Keyzoo0/PemilahBuahNaga/README.md

# 🐉 PemilahBuahNaga

**Sistem konveyor pemilah buah naga otomatis** berbasis **Raspberry Pi 5 + YOLOv8 + Arduino Nano**.
Kamera mendeteksi & mengklasifikasi tingkat kematangan buah naga secara real-time, lalu konveyor
dan lengan servo menyortirnya ke jalur yang sesuai — **berjalan mandiri (offline-first)** tanpa
laptop dan tanpa perlu membuka web.

<p align="center">
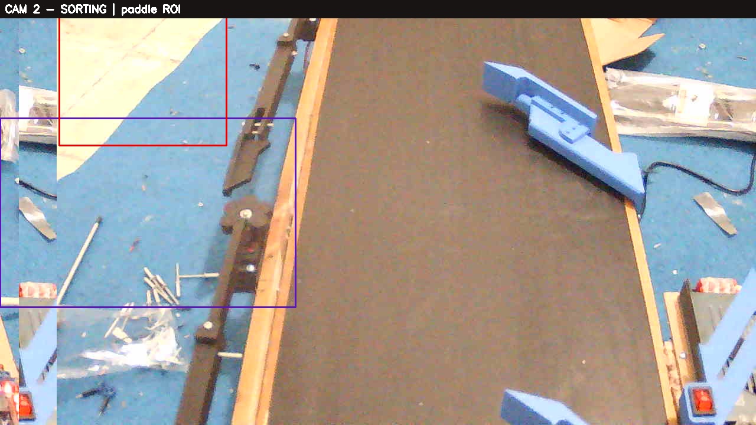
[picture p1: docs/images/sorting_zone.jpg]
Zona sorting: konveyor + 2 lengan servo + ROI paddle
  
</p>

> Deteksi & keputusan sortasi 100% dijalankan di Raspberry Pi 5. Web (Vite + React) hanya untuk
> **monitoring & kalibrasi** — sistem tetap menyortir walau web ditutup atau internet mati.

---

## ✨ Fitur

- 🍎 **Klasifikasi 3 kelas** kematangan: `matang`, `setengah matang`, `mentah` (YOLOv8).
- 🎥 **Dual kamera USB** — Kamera 1 deteksi + klasifikasi, Kamera 2 tracking gerakan saat sorting.
- 🔀 **Sortasi otomatis** via 2 lengan servo + konveyor (motor L298N) dengan mekanisme "tampol".
- 🧠 **State machine** lengkap dengan **failsafe**: watchdog motor, auto-reconnect serial, E-STOP.
- 🌐 **Web monitoring & kalibrasi** (offline/LAN): stream langsung, editor ROI visual, hot-reload config.
- 🔎 **mDNS** — akses langsung di **`http://buahnaga.local:5000`** tanpa perlu tahu alamat IP.
- 🔌 **Identifikasi kamera by USB bus-key** — cam1/cam2 tidak pernah tertukar walau reboot.
- ⚙️ **Systemd service** — otomatis menyala saat boot.

---

## 🧩 Arsitektur

```mermaid
flowchart LR
    subgraph PI[Raspberry Pi 5 - systemd service]
        CAM[CameraManager<br/>2 USB cam by bus-key] --> YOLO[YOLOv8 best.pt]
        YOLO --> SM[Sort State Machine]
        SM --> SER[Serial Bridge]
        SM --> API[FastAPI + WebSocket]
        API --> WEB[Web Vite+React<br/>monitor & kalibrasi]
        CFG[config.json hot-reload] --> SM
    end
    SER -->|USB 115200| NANO[Arduino Nano]
    NANO --> MOT[Motor L298N]
    NANO --> S1[Servo 1]
    NANO --> S2[Servo 2]
    NANO --> LED[LED hijau/kuning/merah]
    NANO --> BUZ[Buzzer]
```

Semua inti (YOLO + state machine + serial) berada di **satu service Python** yang selalu berjalan.
Web adalah build statik yang di-serve service yang sama.

---

## 🔩 Hardware

| Komponen | Detail |
|---|---|
| **Compute** | Raspberry Pi 5 (BCM2712, 4×Cortex-A76 @2.4GHz, 8GB) — Debian 13 |
| **Mikrokontroler** | Arduino Nano (ATmega328P) via USB serial `/dev/ttyUSB0` @115200 |
| **Kamera** | 2× USB camera (DV20/Jieli) — cam1 deteksi, cam2 sorting |
| **Aktuator** | Motor DC konveyor (driver L298N), 2× Servo, 3× LED, Buzzer |

### Pinout Arduino Nano
| Pin | Fungsi | | Pin | Fungsi |
|---|---|---|---|---|
| D2 / D3 | Motor L298N IN1 / IN2 | | D11 | LED hijau (matang) |
| D4 / D5 | Servo 1 / Servo 2 | | D12 | LED kuning (setengah matang) |
| D6 | Buzzer | | D13 | LED merah (mentah) |

---

## 🍎 Model YOLOv8

Model `best.pt` (3 kelas). Contoh deteksi pada belt:

<p align="center">
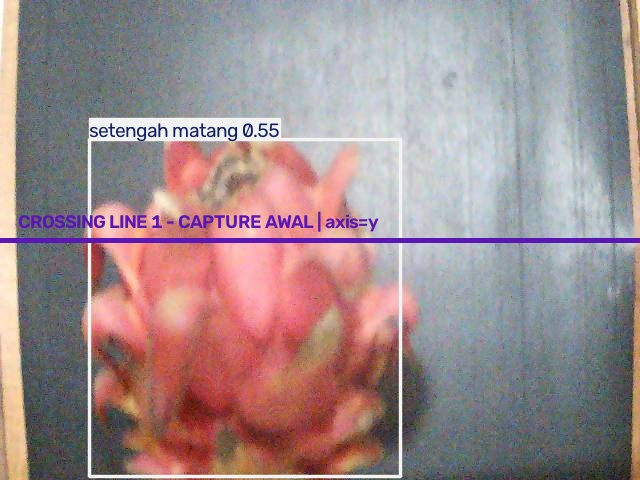
[picture p2: docs/images/detection_top.jpg]
Deteksi kamera atas
  
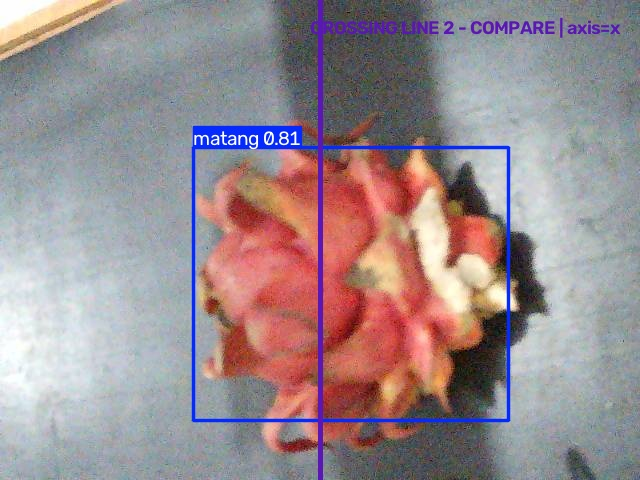
[picture p3: docs/images/detection_side.jpg]
Deteksi kamera samping
  
</p>

| Index | Kelas | Aksi sortasi |
|---|---|---|
| 0 | `matang` | 🟢 Lurus keluar (tanpa servo) |
| 1 | `mentah` | 🔴 Servo 1 (paling dekat) |
| 2 | `setengah matang` | 🟡 Servo 2 |

**Performa di Pi 5** (CPU, 4 thread): imgsz 480 ≈ **5 FPS**, imgsz 320 ≈ **10 FPS**.
Bisa ~2× lebih cepat dengan export NCNN.

### 📊 Hasil Training

Evaluasi model aktif (training 23 Sep 2026, imgsz 416) pada **125 foto uji**:

| Kelas | Jumlah | Precision | Recall | mAP50 | mAP50-95 |
|---|---|---|---|---|---|
| **Semua** | 125 | 97.2% | 96.9% | 98.6% | 75.6% |
| `matang` | 30 | 91.5% | 100% | 97.0% | 73.7% |
| `mentah` | 44 | 100% | 99.6% | 99.5% | 77.4% |
| `setengah matang` | 51 | 100% | 91.1% | 99.3% | 75.6% |

<p align="center">
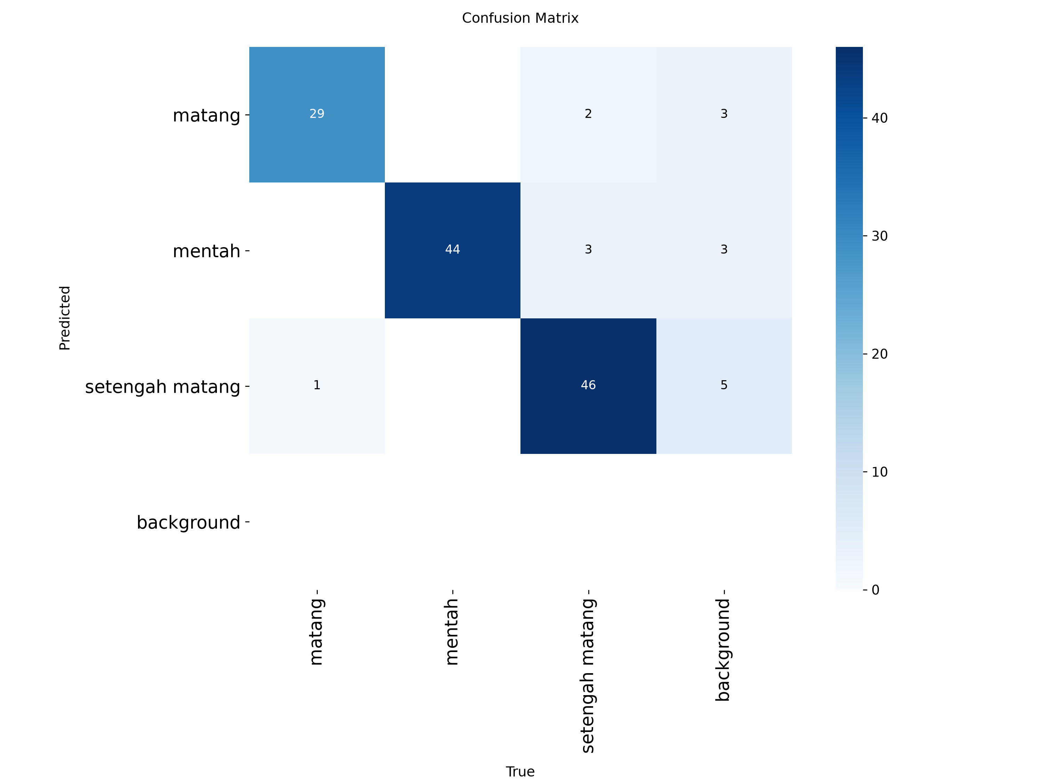
[picture p4: docs/training/confusion_matrix.png]
Confusion matrix
  
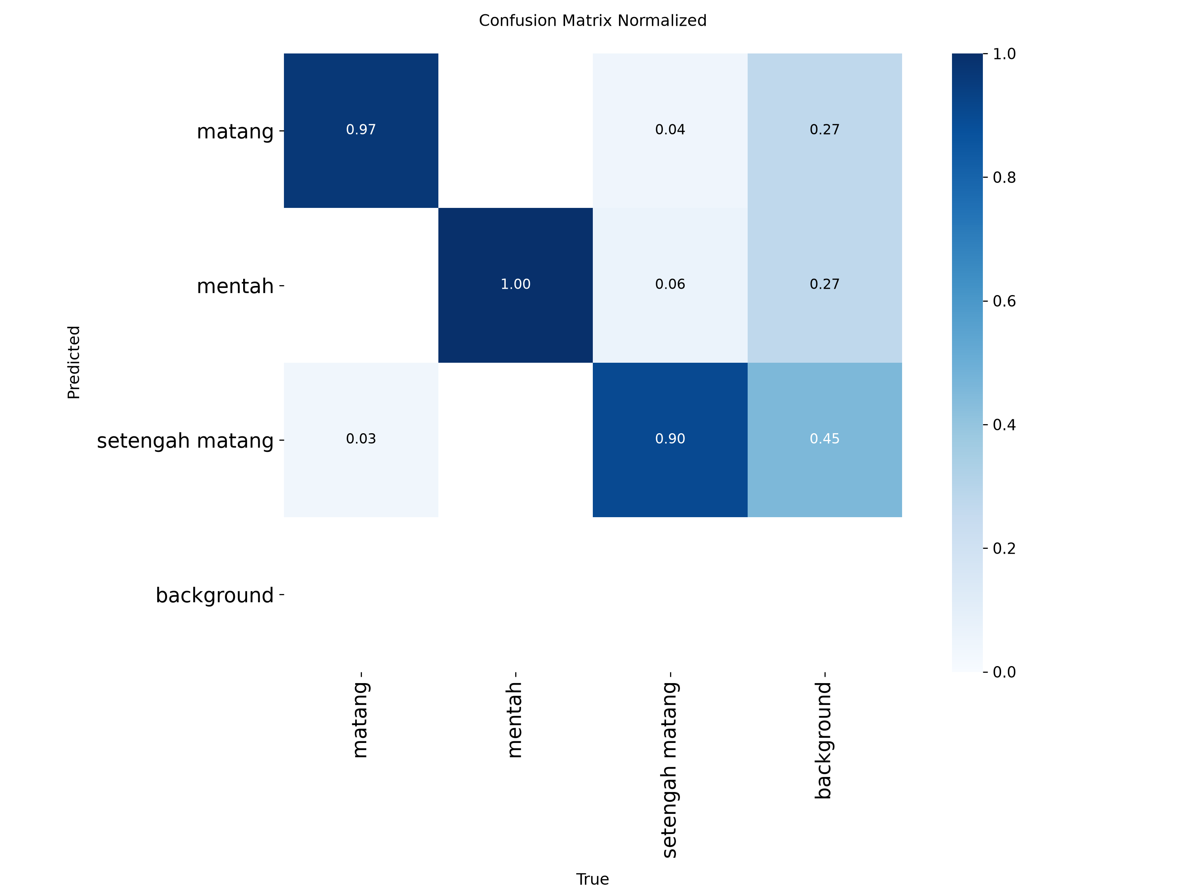
[picture p5: docs/training/confusion_matrix_normalized.png]
Confusion matrix (normalized)
  
</p>

Cara membaca: kolom = kelas **sebenarnya**, baris = **tebakan model**. Diagonal = benar.
Kesalahan terbanyak ada pada `setengah matang` yang kadang dikira `matang` (2) atau
`mentah` (3); kolom *background* = deteksi palsu, dan tidak ada buah yang terlewat.

<p align="center">
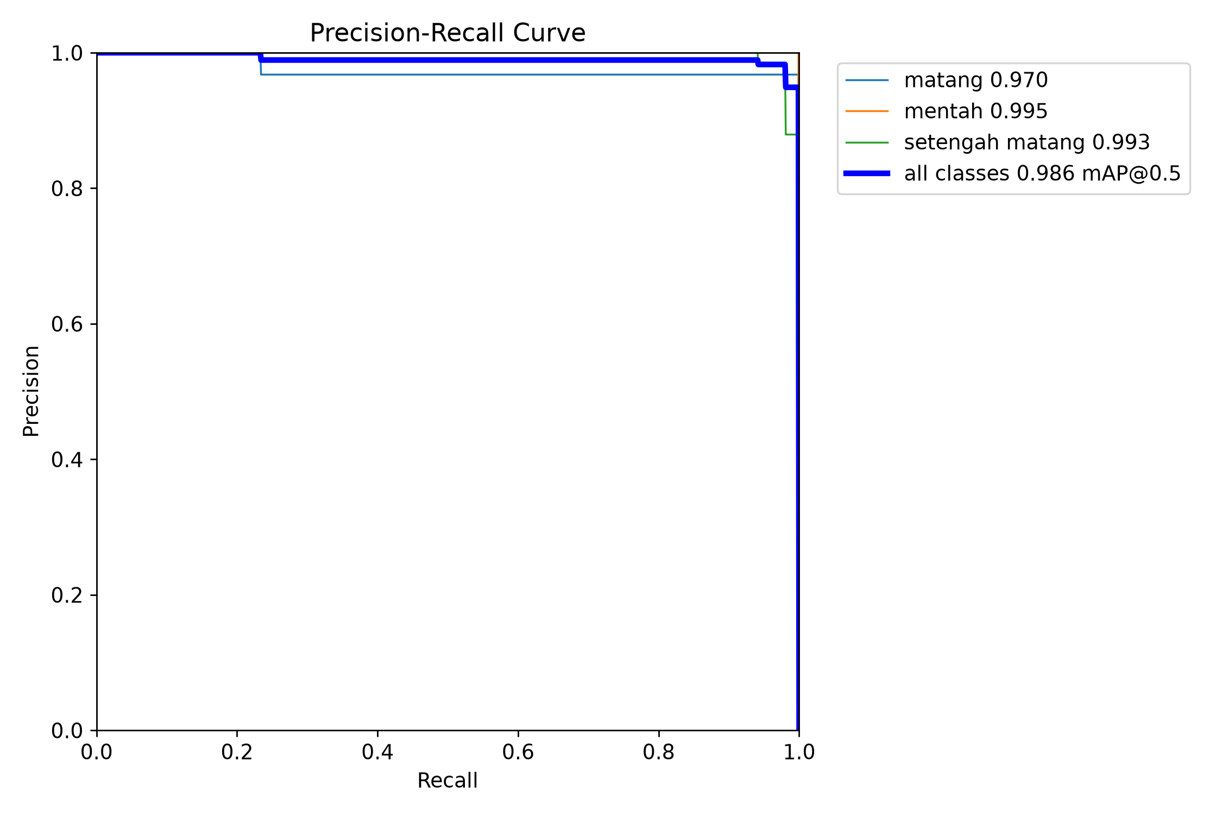
[picture p6: docs/training/BoxPR_curve.png]
Kurva Precision-Recall
  
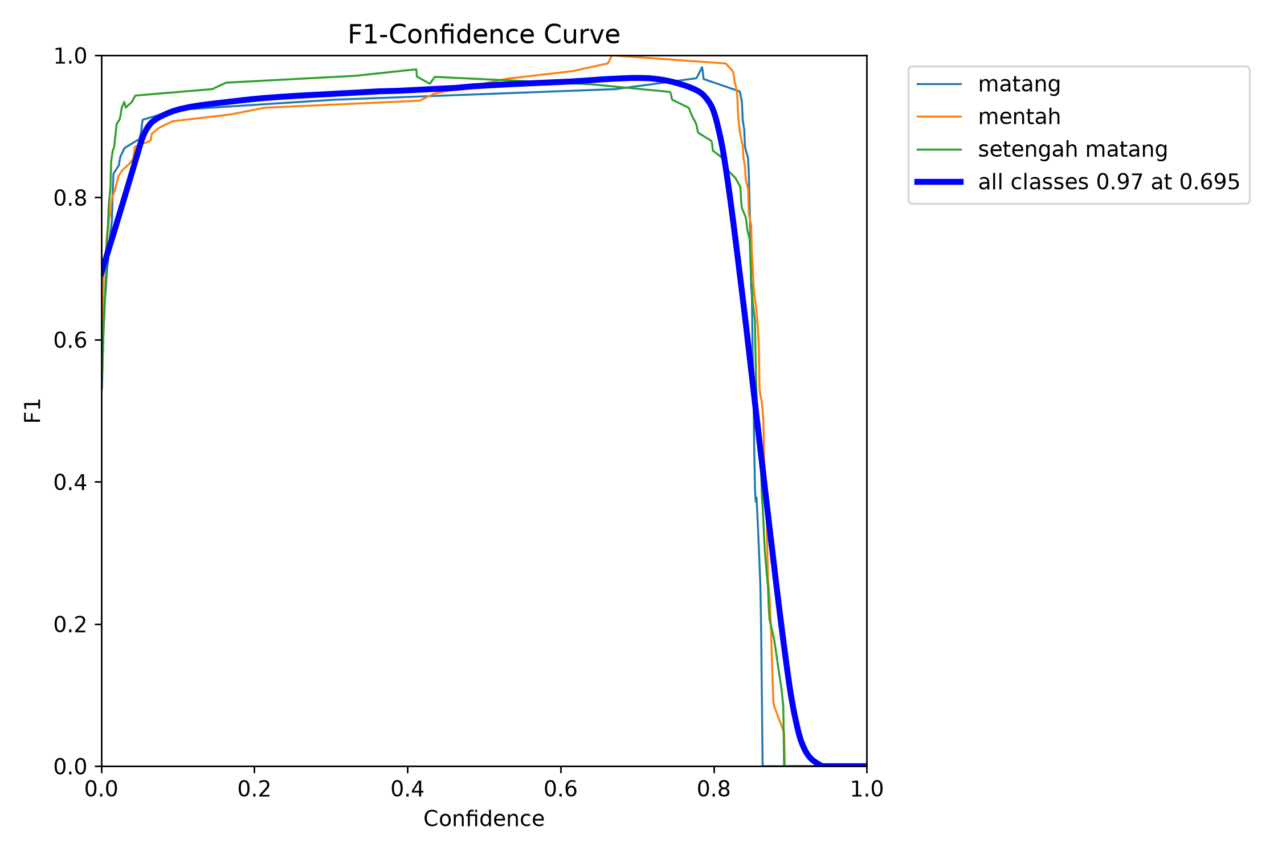
[picture p7: docs/training/BoxF1_curve.png]
Kurva F1
  
</p>

Contoh foto uji — label anotasi (kiri) vs prediksi model (kanan):

<p align="center">
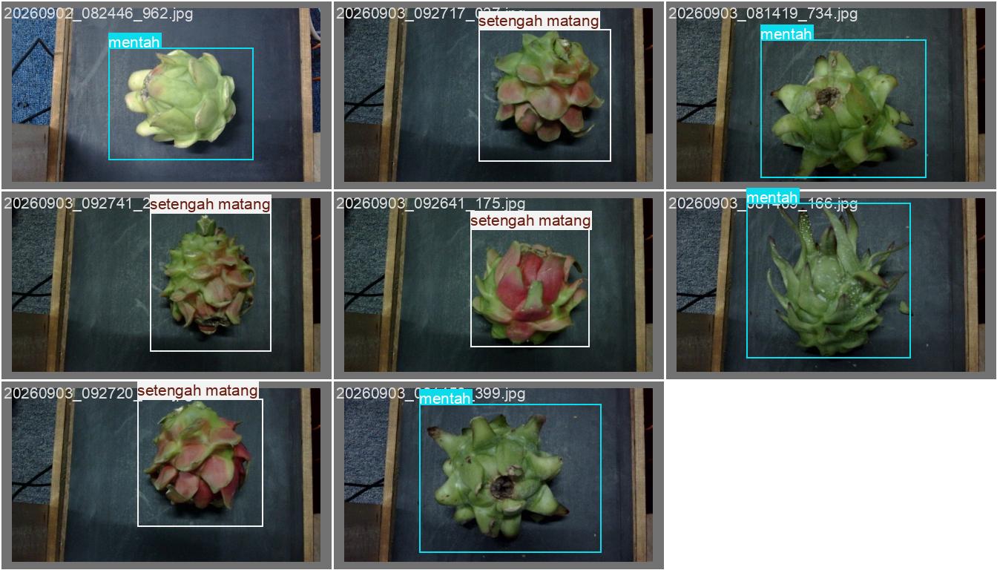
[picture p8: docs/training/val_labels.jpg]
Label anotasi
  
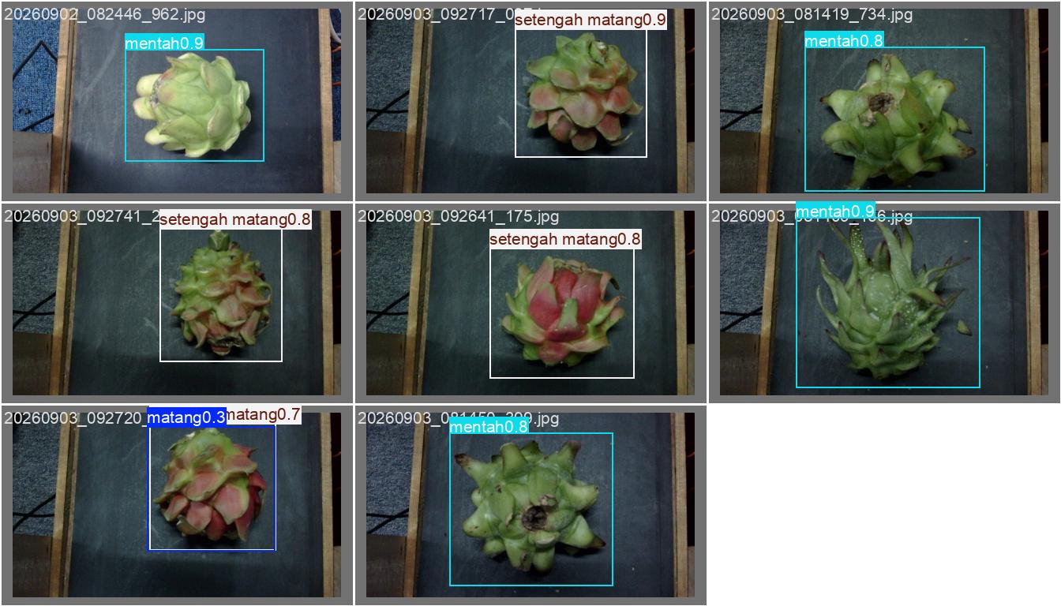
[picture p9: docs/training/val_pred.jpg]
Prediksi model
  
</p>

> ⚠️ Model ini dilatih sebelum pembagian data uji dibuat stabil, sehingga sebagian
> foto uji mungkin pernah terlihat saat training — angka di atas **cenderung sedikit
> terlalu tinggi**. Hasil setiap training baru (confusion matrix, metrik per kelas,
> grafik per epoch, log) tampil langsung di web: **tab Training → Riwayat Training → klik run**.

---

## ⚙️ Alur Kerja (State Machine)

```mermaid
stateDiagram-v2
    [*] --> IDLE
    IDLE --> IDLE : gerakan (tangan) -> tunggu settle
    IDLE --> DISPATCH : BUAH NAGA (setelah diam)
    IDLE --> REJECT_FORWARD : bukan buah naga
    DISPATCH --> STRAIGHT_OUT : matang (mundur)
    DISPATCH --> SERVO_SORT : mentah / setengah (mundur)
    STRAIGHT_OUT --> COOLDOWN : keluar cam2 + 5 detik
    SERVO_SORT --> SERVO_RETURN : cam2 trigger -> tampol (servo 0)
    SERVO_RETURN --> COOLDOWN
    REJECT_FORWARD --> COOLDOWN : maju sampai terbuang
    COOLDOWN --> IDLE
```

1. **Kamera 1** memantau area hitam. Saat objek/tangan masuk → **gerbang settle**: sistem menunggu
   gerakan berhenti (tangan ditarik) agar keputusan tidak salah karena tangan.
2. Setelah objek **diam**:
   - **Buah naga** → LED + beep, konveyor **MUNDUR** ke arah servo:
     - `matang` → mundur lurus keluar belakang, +5 detik.
     - `mentah` → servo 1 buka 51°, mundur, **Kamera 2** melacak → saat mencapai lengan & cukup ke kiri, servo **snap 0° ("tampol")**.
     - `setengah matang` → sama, servo 2.
   - **Bukan buah naga** (objek reject) → konveyor **MAJU** sampai objek terbuang.
3. Watchdog motor & E-STOP menjaga keamanan; motor otomatis berhenti bila terjadi anomali.

> **Anti-tangan:** keputusan hanya diambil saat scene stabil (tidak ada gerakan), sehingga tangan
> saat menaruh buah tidak memicu aksi. Deteksi "bukan buah naga" memakai pembanding **latar belt
> kosong** (kalibrasi sekali via web).

---

## 📁 Struktur Proyek

```
PemilahBuahNaga/
├─ ArduinoNanoFirmware/main/main.ino   # firmware (LED hasil, buzzer, heartbeat failsafe)
├─ core/                               # service Python (offline-first)
│  ├─ main.py            # bootstrap semua komponen + web (port 8000)
│  ├─ config.py / config.json          # parameter kalibrasi (hot-reload)
│  ├─ camera.py          # 2 kamera by USB bus-key
│  ├─ detector.py        # wrapper YOLOv8
│  ├─ state_machine.py   # logika sorting
│  ├─ serial_bridge.py   # serial Arduino (auto-reconnect + heartbeat)
│  ├─ store.py           # SQLite riwayat
│  ├─ api.py             # FastAPI + WebSocket + MJPEG
│  ├─ mdns.py            # publikasi buahnaga.local (Zeroconf)
│  ├─ pemilah-core.service            # unit systemd
│  └─ best.pt            # model YOLOv8
├─ web/                                # Vite + React (monitor & kalibrasi)
│  └─ src/{App, pages/Monitor, pages/Settings, components/RoiEditor}
├─ MainProgramRaspi/camera_identifier.py   # utilitas identifikasi kamera
└─ docs/                               # dokumentasi + gambar
```

---

## 🚀 Instalasi

### 1. Raspberry Pi (core service)
```bash
git clone https://github.com/Keyzoo0/PemilahBuahNaga.git
cd PemilahBuahNaga
python3 -m venv .venv
.venv/bin/pip install -r core/requirements.txt
# torch CPU untuk ARM (tanpa CUDA):
.venv/bin/pip install torch torchvision --index-url https://download.pytorch.org/whl/cpu
```

### 2. Firmware Arduino
```bash
arduino-cli compile --fqbn arduino:avr:nano ArduinoNanoFirmware/main/main.ino
arduino-cli upload  --fqbn arduino:avr:nano --port /dev/ttyUSB0 ArduinoNanoFirmware/main/main.ino
```

### 3. Web (opsional, untuk monitoring)
```bash
cd web && npm install && npm run build   # hasil ke web/dist, di-serve otomatis oleh core
```

### 4. Jalankan
```bash
./core/run.sh                # manual
```
Buka di browser (HP/laptop dalam satu jaringan), tanpa perlu tahu IP berkat **mDNS**:
```
http://buahnaga.local:5000
```

### 5. Auto-start saat boot (systemd)
```bash
sudo cp core/pemilah-core.service /etc/systemd/system/
sudo systemctl daemon-reload
sudo systemctl enable --now pemilah-core
journalctl -u pemilah-core -f
```

---

## 🎛️ Kalibrasi (via Web)

Posisi ROI paddle per servo pada Kamera 2 (pemicu "tampol"):

<p align="center">
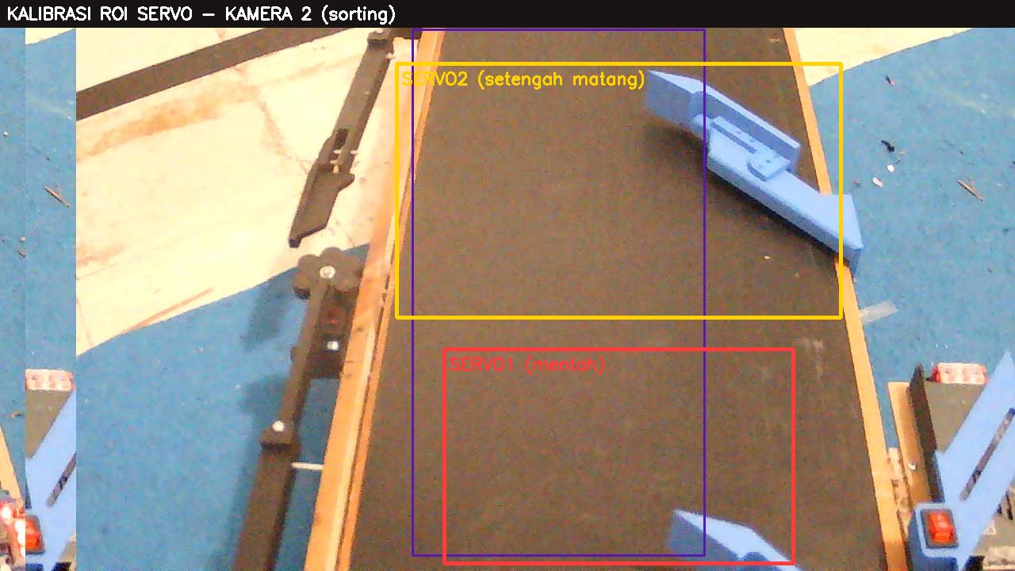
[picture p10: docs/images/servo_calibration.jpg]
Kalibrasi ROI servo pada kamera 2
  
</p>

Buah naga di-"tampol" begitu titik tengahnya masuk kotak servo yang aktif — **Servo 1 (mentah)** & **Servo 2 (setengah matang)** punya zona sendiri karena posisi lengannya berbeda.

Semua parameter di `core/config.json`, dapat diubah dari halaman **Kalibrasi** (hot-reload, tanpa restart):

| Grup | Yang diatur |
|---|---|
| **ROI deteksi (cam1)** | Area hitam tempat buah dihitung (editor visual seret kotak) |
| **ROI paddle (cam2)** | Zona per servo (`paddle_roi_1`/`paddle_roi_2`) — buah masuk kotak = tampol; `track_conf` sensitivitas deteksi cam2 |
| **Anti-tangan (settle)** | Ambang gerakan, jumlah frame diam sebelum memutuskan |
| **Latar belt kosong** | Tombol "Simpan Latar Belt Kosong" untuk deteksi objek reject |
| **Deteksi** | `imgsz`, confidence, min box area, presence/exit frames |
| **Timing** | Backward matang +5s, sudut servo 51°/0°, cooldown, watchdog, durasi buang reject |
| **Mapping** | Kelas → servo1 / servo2 / lurus |
| **Kamera & Serial** | bus-key, resolusi, port, baud |

Tersedia juga **mode manual** untuk menguji motor/servo/buzzer satu per satu saat kalibrasi.

---

## 📟 Protokol Serial (Arduino)

| Command | Fungsi |
|---|---|
| `result <matang\|setengah\|mentah\|none>` | LED hasil + beep |
| `motor <forward\|backward\|stop>` | Konveyor |
| `s1/s2 <open\|close>` | Servo 51° / 0° |
| `beep <n>` · `buzzer <on\|off>` | Buzzer |
| `ping` · `watchdog <on\|off>` | Keep-alive & failsafe motor |

Indikator: 🟢 matang · 🟡 setengah matang · 🔴 mentah · ketiga LED kedip + buzzer = **FAULT**.

---

## 🛡️ Keamanan & Failsafe

- **Watchdog motor**: bila buah tak terdeteksi keluar dalam batas waktu → motor berhenti + alarm.
- **Heartbeat firmware**: bila Pi diam >2 dtk saat motor jalan → Arduino menghentikan motor sendiri.
- **Auto-reconnect** serial & kamera. **E-STOP** dari web kapan saja.

---

## 📝 Lisensi

Proyek edukasi/riset. Model YOLO menggunakan Ultralytics (AGPL-3.0).

**Dibuat oleh [Keyzoo0](https://github.com/Keyzoo0)** — 2026.
