Keyzoo0/PemilahBuahNaga/MainProgramRaspi/testCamera/script/index.html

🐉

# PemilahBuahNaga

Dual Camera Real-Time Monitor

Connecting...

CAM 1 --

Camera 1

Camera 1

CAM 2 --

Camera 2

Camera 2

PemilahBuahNaga © 2026 — Raspberry Pi 5
