Keyzoo0/PemilahBuahNaga/(commit log)

2026-07-23 Sistem pemilah buah naga otomatis: Pi5 + YOLOv8 + Arduino Nano
    - core/: service Python offline-first (YOLO + state machine + serial + FastAPI)
    - ArduinoNanoFirmware: firmware LED hasil + buzzer + heartbeat failsafe
    - web/: monitoring & kalibrasi (Vite + React, editor ROI visual)
    - docs/: desain sistem, spesifikasi hardware, gambar
    Claude-Session: https://claude.ai/code/session_01Fxm4N6fR41yzEM7WQd2Uw6
    [api.py, camera.py, config.py, detector.py, main.ino, main.py, serial_bridge.py]
2026-07-23 Auto-boot systemd: service + boot mode manual (aman)
    - config: system.start_mode=manual agar konveyor tak bergerak saat power-on
    - state_machine: hormati start_mode saat init
    - pemilah-core.service: network-online.target + PYTHONUNBUFFERED
    - kalibrasi ROI cam1 awal
    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
2026-07-23 Perbaikan alur: buah naga mundur (bukan forward) + gerbang anti-tangan
    Bug utama: buah naga ikut di-forward sampai terbuang. Sekarang:
    - Buah naga -> MUNDUR ke servo (matang lurus, mentah=S1, setengah=S2)
    - Bukan buah naga -> FORWARD sampai terbuang (reject)
    - Gerbang settle + deteksi gerakan: keputusan hanya saat scene stabil
    (tangan saat menaruh tidak lagi memicu aksi)
    - Deteksi reject via latar belt kosong (endpoint /api/calibrate/empty)
    - Web: tombol simpan latar, parameter settle/reject, indikator gerakan
    - Default start_mode=auto: boot langsung jalan tanpa buka web
    Claude-Session: https://claude.ai/code/session_01Fxm4N6fR41yzEM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
    [api.py, state_machine.py]
2026-07-23 Perbaiki trigger tampol cam2: ROI paddle per servo
    - Trigger tampol saat buah masuk ROI (bukan rasio kiri yg keliru;
    lengan servo ada di kanan sehingga trigger lama tak pernah kena)
    - ROI terpisah paddle_roi_1 (servo1) & paddle_roi_2 (servo2) karena
    posisi lengan berbeda; kalibrasi awal disetel
    - track_conf cam2 (0.25) agar buah bergerak tetap terdeteksi
    - Web: dua editor ROI paddle per servo
    - docs: gambar posisi kalibrasi servo
    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
2026-07-23 LED jadi indikator status sistem + buzzer pola baru
    - KUNING = Raspi belum siap (serial putus / kamera mati / fault / manual / e-stop)
    - HIJAU = siap, buah boleh ditaruh di kamera 1 (IDLE)
    - MERAH = sedang sorting -> buzzer bip-bip berulang
    - Transisi ke HIJAU = bip panjang 1.5 detik
    - LED tidak lagi menandakan kelas kematangan (kelas tetap tampil di web)
    - Fix: tidak memulai siklus sortir saat perangkat belum siap
    (mencegah sortir gagal -> FAULT saat kamera terputus)
    - Web: banner indikator LED di halaman Monitor
    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
    [state_machine.py]
2026-07-23 Tampilkan index kelas buah di web setelah klasifikasi
    - detector: Detection membawa cls_id + peta class_names/label_to_index dari model
    - state_machine: ripeness_index dikunci saat klasifikasi, masuk /api/status
    - api: endpoint /api/classes (0=matang, 1=mentah, 2=setengah matang)
    - web: badge "INDEX KELAS" di banner + kolom Index di tabel riwayat
    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
2026-07-23 Fix servo1 tidak menampol: ambang confidence tracking cam2
    Penyebab: track_conf (0.6-0.7) >= confidence deteksi di zona servo1 (~0.6),
    sehingga deteksi dibuang sebelum dicek masuk ROI -> tampol tak pernah terpicu.
    - track_conf diturunkan ke 0.40 (margin di bawah deteksi nyata)
    - pisahkan track_draw_conf (0.15): semua kandidat tetap digambar di stream
    agar confidence terlihat saat kalibrasi, tapi pemicu tampol pakai track_conf
    - _state_servo_sort kini memeriksa SEMUA deteksi (bukan hanya conf tertinggi)
    sehingga buah ber-confidence sedang tetap memicu tampol
    - pesan transisi mencantumkan confidence saat menampol
    - straight_out memakai track_conf untuk menentukan buah keluar frame
    Co-Aut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
    [state_machine.py]
2026-07-23 Fix tampol terpicu seketika: jeda lengan siap + diagnostik posisi cam2
    Penyebab: FOV cam1 & cam2 tumpang tindih, jadi begitu SERVO_SORT dimulai
    cam2 sudah melihat buah (conf 0.79) di dalam paddle_roi yang lebar ->
    tampol terpicu di frame yang sama, buah belum sampai paddle.
    - timing.servo_arm_delay_seconds (default 1.0s): tahan pemicu tampol
    sampai buah sempat berjalan mendekat
    - status.cam2_best {cx,cy,conf}: posisi deteksi cam2 tampil di web
    agar ROI paddle bisa digambar tepat di posisi lengan
    - Settings: field jeda lengan siap
    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
    [state_machine.py]
2026-07-23 Fix deadlock settle & loop reject: tekan noise sensor + deteksi objek tahan tekstur
    Dua bug saling terkait, keduanya akibat noise/tekstur terbaca sebagai perubahan:
    1) Konveyor tak mau jalan (deadlock gerbang settle)
    - noise sensor kamera membuat "gerakan" terukur ~5.4 walau belt diam,
    selalu di atas ambang -> settle tak pernah selesai
    - fix: ROI gerakan di-downscale + Gaussian blur -> noise floor 5.4 turun ke 0.8
    - tambah detect.settle_timeout_seconds (8s) sebagai anti-deadlock
    2) Loop REJECT tanpa henti
    - belt bertekstur yang bergeser berbeda dari foto latar -> dikira objek asing
    - fix: foreground pakai KOMPONEN TERBESAR (bukan total piksel) +
    blur/downscale + mo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
    [state_machine.py]
2026-07-23 Refresh latar otomatis tiap siklus + fix tampol dini servo2
    1) Latar belt di-refresh otomatis setelah tiap siklus (ide praktis dari lapangan):
    belt terus berputar sehingga permukaannya tak pernah sama dan latar lama
    cepat basi -> reject palsu berulang. Dijaga: tidak menyimpan bila masih ada
    objek terdeteksi, agar buah tak "menyatu" jadi latar.
    2) Tampol dini pada servo2: buah sudah terlihat cam2 sejak awal (FOV cam1 & cam2
    tumpang tindih) sehingga langsung dianggap sampai di lengan.
    - syarat baru sort_cam2.min_travel_px (120): buah wajib menempuh jarak dari
    posisi awalnya sebelum boleh ditampol -> tidak bergantung timing
    - jeda lengan kini per-servo (servo_arm_delay_1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
    [state_machine.py]
2026-07-23 Fitur dataset, anotasi, dan training YOLO di Pi + hapus riwayat sortasi
    Riwayat:
    - tombol hapus per-baris dan hapus semua (DELETE /api/history[/{id}])
    Dataset (core/dataset.py + tab web):
    - capture frame cam1, disimpan langsung 640px agar ringan & siap latih
    - galeri dengan status anotasi + tombol hapus per gambar
    - label format YOLO .txt sejajar gambar (tanpa database)
    Anotasi (ala Roboflow):
    - seret kotak di atas gambar, pilih 1 dari 3 kelas (0 matang, 1 mentah,
    2 setengah matang) sesuai index model, undo/hapus/simpan
    Training:
    - fine-tune dari model aktif dengan backbone dibekukan (freeze=10),
    imgsz kecil, batch kecil, cache RAM -> memungkinkan latih di CPU ARM
    - jalan sebagai subp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
2026-07-27 Fix path model hasil training (ultralytics menyisipkan subfolder)
    Terungkap saat uji training 1-epoch nyata (16s/7 gambar, mAP50 OK):
    ultralytics menyimpan ke runs/detect/runs/<name>/weights/best.pt, bukan
    runs/<name>/weights/best.pt. Deteksi model kini rekursif (rglob) sehingga
    tahan pola path apa pun; list_models & pencarian hasil training diperbaiki.
    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
    [dataset.py]
2026-07-28 Sederhanakan sortir cam2 + perbaiki self-heal kamera & bug training
    SORTIR CAM2 (sesuai masukan: 'deteksi perubahan warna di area -> tampol'):
    - Buang YOLO di cam2, jarak-tempuh, arm-delay, track_conf/draw_conf/min_travel
    yang ribet & buggy (titik buta, tampol dini).
    - Baru: saat servo buka, ambil baseline paddle kosong; begitu ADA PERUBAHAN
    WARNA di kotak paddle servo aktif (buah masuk) -> langsung tampol.
    servo1(mentah)=paddle_roi_1 bawah, servo2(setengah)=paddle_roi_2 atas.
    - Matang: mundur lurus durasi tetap (tak perlu deteksi keluar frame) -> hilang
    bug 'tidak bisa deteksi keluar'.
    KAMERA SELF-HEAL:
    - FIX DEADLOCK: _open memegang _OPEN_LOCK lalu _maybe_reset ambil lock sama ->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
    [camera.py, dataset.py, main.py, mdns.py, state_machine.py]
2026-07-28 Jeda titik-buta + audit: hapus bug duplikat _infer & import tak terpakai
    - Titik buta: sebelum cek paddle, mundur dulu blind_spot_seconds (2s) supaya
    buah menyeberang gap cam1->cam2; baseline paddle diambil SETELAH jeda (segar,
    tahan gerak belt). Field baru di Kalibrasi.
    - Audit pyflakes seluruh core: _infer terdefinisi DUA KALI (dihapus salah satu),
    import FileResponse tak terpakai (dihapus). Sisanya nol peringatan.
    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
    [api.py, state_machine.py]
2026-07-28 Ambang tampol per-servo + matang mundur sampai keluar cam2
    - Sensitivitas tampol kini per servo: slap_area_ratio_1 (mentah/servo1) &
    slap_area_ratio_2 (setengah/servo2). Field terpisah di Kalibrasi.
    - Matang: bug 'berhenti di titik buta' diperbaiki. Sekarang mundur lurus,
    deteksi buah lewat cam2 (perubahan naik lalu turun = keluar), baru mundur
    extra lalu berhenti. Pakai deteksi perubahan warna full-frame cam2.
    - Helper _area_change generik (paddle & matang pakai yang sama).
    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
    [state_machine.py]
2026-07-28 Matang: naikkan waktu mundur 6->12s + pastikan servo tertutup
    Log menunjukkan matang mundur cuma 6s (setengah butuh ~7s capai servo2), jadi
    buah baru sampai tengah cam2 -> nyangkut. Naikkan default ke 12s + watchdog 20s.
    Servo dipastikan close saat matang agar buah tak terganjal lengan.
    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
2026-07-28 Matang: waktu mundur 6s (sesuai ukur user 5s+margin)
    Akar nyangkut = servo terbuka dari siklus sebelumnya mengganjal buah matang
    (sudah diperbaiki: matang menutup kedua servo di awal). Waktu 12s tadi
    kelebihan; user ukur buah keluar max 5s -> set 6s.
    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
2026-07-28 Anti-nyangkut: kirim ulang perintah motor tiap 0.5s selama fase gerak
    Kemungkinan besar penyebab buah 'nyangkut': perintah motor dikirim SEKALI di
    awal; kalau hilang di serial (glitch USB), motor tak pernah jalan -> buah diam.
    Sekarang _keep_motor() mengirim ulang perintah arah motor tiap 0.5s di semua
    fase gerak (matang/servo/reject). Semua motor_stop -> _stop_motor (clear arah).
    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
    [state_machine.py]
2026-07-28 Export model .pt -> ONNX/NCNN (lebih ringan di Pi) + klarifikasi dataset
    Dataset: TERBUKTI training/build_split TIDAK menghapus gambar (symlink saja).
    'Hilang' sebelumnya karena perintah cleanup testing. Kode aman, dataset
    dipertahankan (37 gambar asli utuh).
    Export model:
    - dataset.export_model_async(onnx|ncnn) via YOLO.export, background thread,
    sorting -> MANUAL selama export
    - API /api/model/export + /status; /api/models kini kirim active_kind
    - detector prioritas: NCNN > ONNX > .pt (otomatis pakai yang teroptimasi)
    - web Training: tombol Export ONNX / NCNN + status
    - ONNX teruji: 4.0->4.8 fps (~1.2x); NCNN ~2x di ARM
    Claude-Ses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
2026-08-09 docs: komentar penjelasan baris-per-baris untuk pemula di seluruh kode
    Menambahkan komentar berbahasa Indonesia yang menjelaskan setiap bagian kode
    seolah untuk pembaca yang baru belajar pemrograman. Tidak ada logika program
    yang diubah — hanya komentar dan docstring.
    Cakupan (24 file):
    - core/ : main, config, camera, detector, state_machine, serial_bridge,
    store, api, mdns, dataset
    - Arduino : ArduinoNanoFirmware/main/main.ino
    - MainProgramRaspi : camera_identifier, testCamera/main.py, script/main.js
    - web/ : api.js, App.jsx, main.jsx, vite.config.js, RoiEditor.jsx,
    pages/{Monitor,Settings,Dataset,Annotate,Training}.jsx
    Yang dijelaskan an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
2026-08-09 fix(deps): vite 5.4.11 -> 6.4.3, tutup 4 alert Dependabot
    Semua alert berada di devDependency (build tool), bukan di kode yang
    berjalan di Raspberry Pi:
    high vite server.fs.deny bypass di Windows -> patched 6.4.3
    medium vite launch-editor NTLMv2 disclosure -> patched 6.4.3
    medium vite path traversal optimized deps .map -> patched 6.4.2
    medium esbuild dev server terima request lintas-situs -> patched 0.25.0
    Terpasang sekarang: vite 6.4.3, esbuild 0.25.12 (transitif dari vite).
    `npm audit fix` juga menaikkan 2 transitif yang baru terdeteksi setelahnya:
    nanoid 3.3.18 dan postcss 8.5.26. Hasil akhir: npm audit = 0 vulnerabilities.
    Kenapa 6.4.3, bukan ^8.1.5 seperti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
2026-09-28 Tambah confusion matrix hasil validasi model + update model & kalibrasi ROI
    Run training sebelumnya semua pakai plots:false jadi tak pernah simpan
    confusion matrix; sekarang digenerate dari validasi best.pt terhadap
    dataset yang ada (docs/training/). Sekalian ikut push model & kalibrasi
    config yang sudah diubah di raspi (ROI, threshold, fallback yolov8n.pt
    saat best.pt tak ada, ganti export ke NCNN).
    [model.ncnn.param]
2026-09-28 Web: putus stream kamera saat tab ditinggal + detail run bisa coba lagi
    Chrome tidak menutup koneksi MJPEG saat <img> dihapus, sehingga setelah
    pindah-pindah tab slot koneksi (±6 per server) habis dan permintaan /api
    mengantre tanpa akhir (halaman tampak kosong / "Memuat..." selamanya).
    Komponen Stream mengosongkan src saat unmount untuk menutup koneksinya.
    Detail run kini berhenti menunggu setelah 15 detik dan menampilkan error
    beserta tombol Coba lagi.
    Claude-Session: https://claude.ai/code/session_01Rhras1qoX75YsKQq5FWxxM
